hung-c/quadruped.robot/schema.png

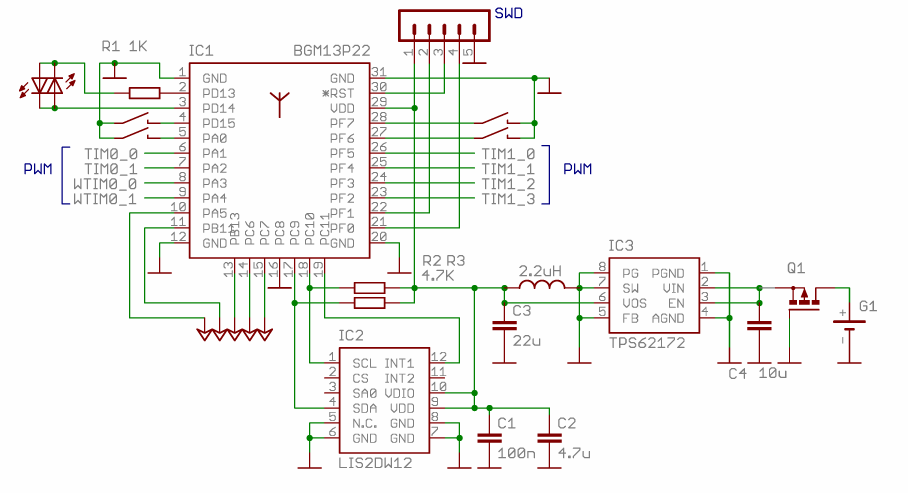
schema.png
