hung-c/quadruped.robot/BOM.xlsx

Index | Quantity | Part Number | Manufacturer Part Number | Description | Customer Reference | Available | Backorder | Unit Price | Extended Price USD
1 | 1 | 1904-1018-1-ND | ESP-WROOM-02 (4MB) | RX TXRX MOD WIFI TRACE ANT SMD |  | 1 | 0 | 3 | 3.00
2 | 2 | S9017E-05-ND | GRPB052MWCN-RC | CONN HEADER R/A 10POS 1.27MM |  | 2 | 0 | 0.98 | 1.96
3 | 1 | 497-19047-1-ND | LIS2DTW12TR | MEMS DIGITAL OUTPUT DUAL MOTION |  | 1 | 0 | 2.86 | 2.86
4 | 10 | RMCF0402FT51R0CT-ND | RMCF0402FT51R0 | RES 51 OHM 1% 1/16W 0402 |  | 10 | 0 | 0.014 | 0.14
5 | 1 | 336-5146-1-ND | BGM13P22F512GA-V2R | RX TXRX MOD BLUETOOTH CHIP SMD |  | 1 | 0 | 9.08 | 9.08
6 | 1 | 296-39449-1-ND | TPS62172DSGR | IC REG BUCK 3.3V 500MA 8WSON |  | 1 | 0 | 1.29 | 1.29
7 | 1 | 587-2905-1-ND | BRC2012T2R2MD | FIXED IND 2.2UH 1A 143 MOHM SMD |  | 1 | 0 | 0.35 | 0.35
8 | 1 | SI2321-TPMSCT-ND | SI2321-TP | P-CHANNEL MOSFET, SOT-23 PACKAGE |  | 1 | 0 | 0.41 | 0.41
9 | 1 | 1276-6780-1-ND | CL21A226MOCLRNC | CAP CER 22UF 16V X5R 0805 |  | 1 | 0 | 0.33 | 0.33
10 | 1 | 587-1441-1-ND | LMK107BJ475KA-T | CAP CER 4.7UF 10V X5R 0603 |  | 1 | 0 | 0.19 | 0.19
11 | 1 | 1276-1096-1-ND | CL21A106KOQNNNE | CAP CER 10UF 16V X5R 0805 |  | 1 | 0 | 0.18 | 0.18
12 | 2 | 2057-PH2-04-UA-ND | PH2-04-UA | CONN HEADER VERT 4POS 2.54MM |  | 2 | 0 | 0.1 | 0.20
13 | 1 | 2057-PH1-02-UA-ND | PH1-02-UA | CONN HEADER VERT 2POS 2.54MM |  | 1 | 0 | 0.1 | 0.10
14 | 1 | 2057-PH2-06-UA-ND | PH2-06-UA | CONN HEADER VERT 6POS 2.54MM |  | 1 | 0 | 0.12 | 0.12
15 | 2 | SAM12310-ND | TSW-104-07-L-T | CONN HEADER VERT 12POS 2.54MM |  | 2 | 0 | 1.11 | 2.22
16 | 1 | S9008E-05-ND | LPPB051NFFN-RC | CONN HDR 5POS 0.05 GOLD PCB |  | 1 | 0 | 0.89 | 0.89
17 | 1 | S7035-ND | PPPC021LFBN-RC | CONN HDR 2POS 0.1 GOLD PCB |  | 1 | 0 | 0.33 | 0.33
18 | 2 | S7105-ND | PPPC022LFBN-RC | CONN HDR 4POS 0.1 GOLD PCB |  | 2 | 0 | 0.58 | 1.16
19 | 1 | S7106-ND | PPPC032LFBN-RC | CONN HDR 6POS 0.1 GOLD PCB |  | 1 | 0 | 0.62 | 0.62
20 | 4 | 480-6241-ND | ZM10B10A01 | SWITCH SNAP ACT SPDT 100MA 125V |  | 4 | 0 | 2.15 | 8.60
21 | 1 | 2057-PH1-03-UA-ND | PH1-03-UA | CONN HEADER VERT 3POS 2.54MM |  | 1 | 0 | 0.1 | 0.10
22 | 1 | 754-1751-ND | WP937EGW | LED GREEN/RED DIFFUSED T-1 T/H |  | 1 | 0 | 0.53 | 0.53
