hung-c/quadruped.robot/(commit log)

2026-10-19 Document the quadruped firmware, hardware, and gait.
    Replace the one-line slide link with the servo map, inverse kinematics, and what app.c actually runs.
2026-10-19 Add an illustrated guide with the build videos.
    Link the three clips and explain the five-bar leg, the diagonal trot, and the control path next to the firmware notes.
2026-10-19 Show the robot photos at the top of the README.
    Use stills from the three build videos so the page opens on the walker and the single leg.
